lesquoyb/clockinator/docs/design/prototype.html

Clockinator / exploration UX

# Horaires, routines et réveil.

Une interface organisée autour de ce que vous voulez faire : préparer la prochaine nuit, ajuster vos routines et contrôler le réveil.

- Aujourd’hui — la prochaine étape, son contexte et un accès rapide à l’exception.
- Routines — une frise à toucher, des jours à choisir, des détails à ouvrir au besoin.
- Réveil — volume et lumière d’abord ; connexion et diagnostic en détail.

Maquette interactive, données fictives. Essayez la navigation, « Modifier », le saut d’événement, le volume, la lumière et les réglages d’apparence. Rien n’est envoyé à un appareil.

Lire l’audit et les parcours complets

21:14Mode démo

Réglages

Prochain événement

## Aujourd’hui

### Poser le téléphone

Ce soir

22:00

Téléphone + réveil · Semaine

Passer cet événement →

Réveil disponible

État simulé · aucune connexion réelle

Du soir au matin

☾

Se coucher

Ce soir · réveil

23:00

☀

Se réveiller

Demain · téléphone + réveil

07:00

Vos routines

## Routines

### Semaine

Active

Lun – Ven

☾

Poser le téléphone

Téléphone + réveil

22:00

◔

Se coucher

Réveil

23:00

☀

Se réveiller

Téléphone + réveil

07:00

Modifier la routine

Dans cette exploration, une seule routine d’exemple est modifiable. La création et les autres rythmes sont décrits dans l’audit.

Appareil

## Réveil

Clockinator · chambre

Appareil fictif pour la maquette

Le son

### Volume du réveil

3 / 5

12345

Réglage simulé, sans aperçu sonore.

### Lumière

Couleur de la lumière

Éteinte

Ivoire · sélection locale

Connexion, bibliothèque de sons et diagnostic sont détaillés dans la proposition de parcours.

← Retour

## Réglages

### Apparence

Suivre le système ou choisir un thème.

SystèmeClairSombre

Choix conservé dans cette maquette.

À regrouper ici dans l’application

Tags et Focus, permissions Android et synchronisation en arrière-plan. Les commandes du réveil restent dans « Réveil ».

Le thème sombre existe déjà dans Android. Le sélecteur montré ici est une proposition d’évolution.

Routine / étape Réveil

## Heure et jours

Nom de la routineHeure du réveil

Le réveil sonne toujours. Dans l’application, chaque étape dispose de sa feuille de réglage.

Jours actifs

LMMJVSD

Choisissez au moins un jour.

AnnulerEnregistrer
