lesquoyb/clockinator/case-dock/output/dock-L-parts.step

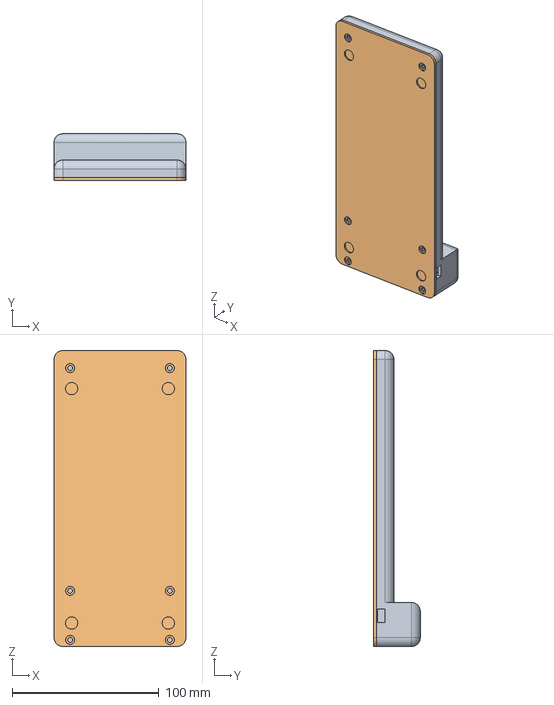
[picture p5: CAD file, 2026-11-05]
case-dock/output/dock-L-parts.step
90.0 x 31.8 x 202.0 mm
