lesquoyb/clockinator/case-v3/output/clockinator-v3-parts.step

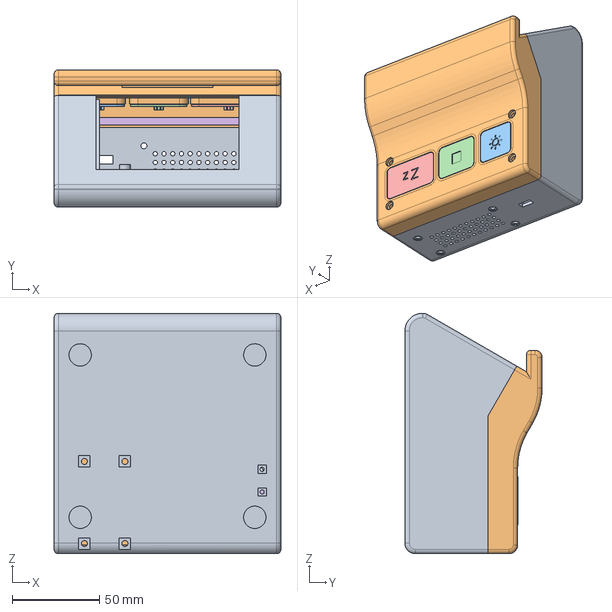
[picture p6: CAD file, 2026-11-12]
case-v3/output/clockinator-v3-parts.step
130.0 x 78.6 x 137.6 mm
