lesquoyb/clockinator/case-dock/output/dock-L-bottom-cover.stl

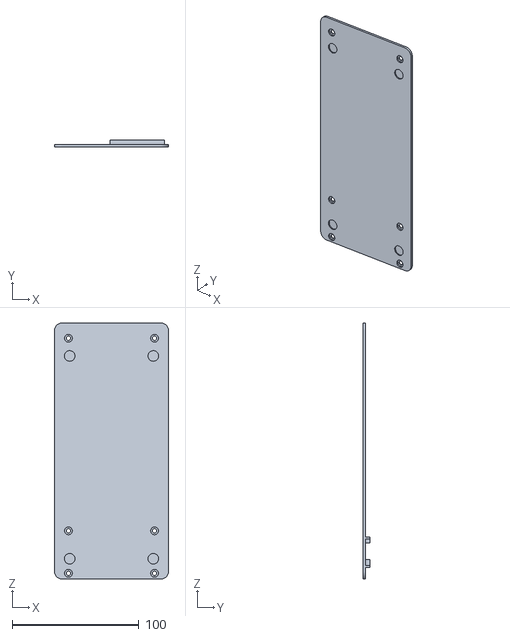
[picture p7: CAD file, 2026-11-05]
case-dock/output/dock-L-bottom-cover.stl
90.0 x 5.30 x 202.0
