lesquoyb/clockinator/case-v3/output/lid.stl

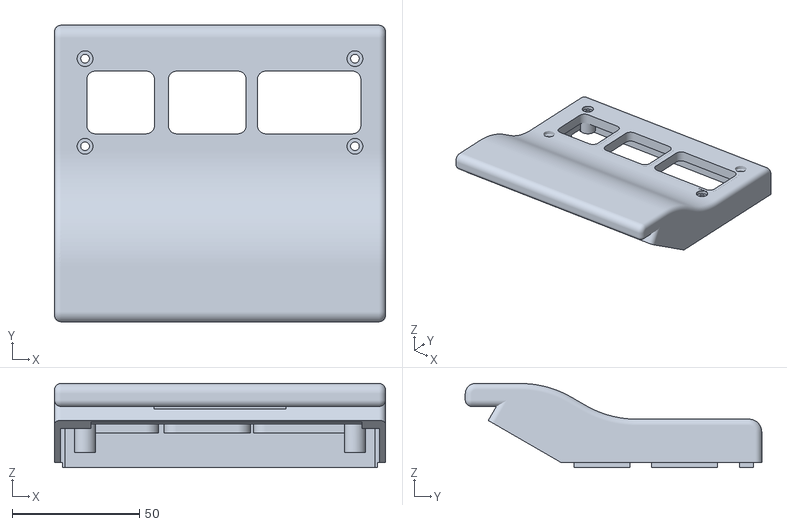
[picture p8: CAD file, 2026-11-12]
case-v3/output/lid.stl
130.0 x 116.5 x 33.0
