lesquoyb/clockinator/case-dock/output/dock-L-body.stl

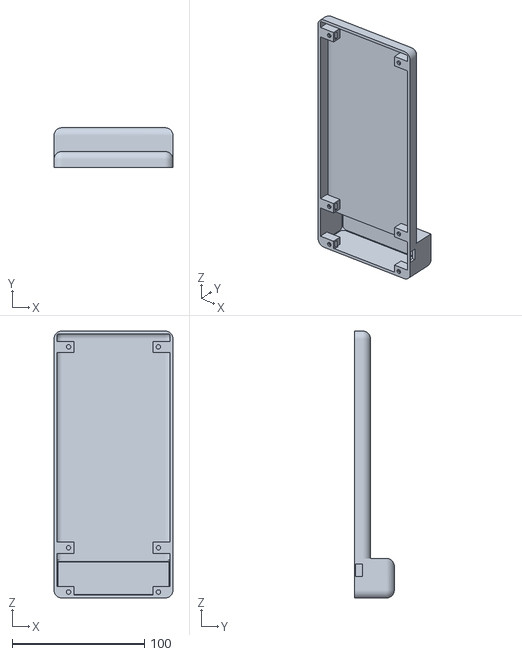
[picture p9: CAD file, 2026-11-05]
case-dock/output/dock-L-body.stl
90.0 x 30.0 x 202.0
