lesquoyb/clockinator/case-v3/output/shell.stl

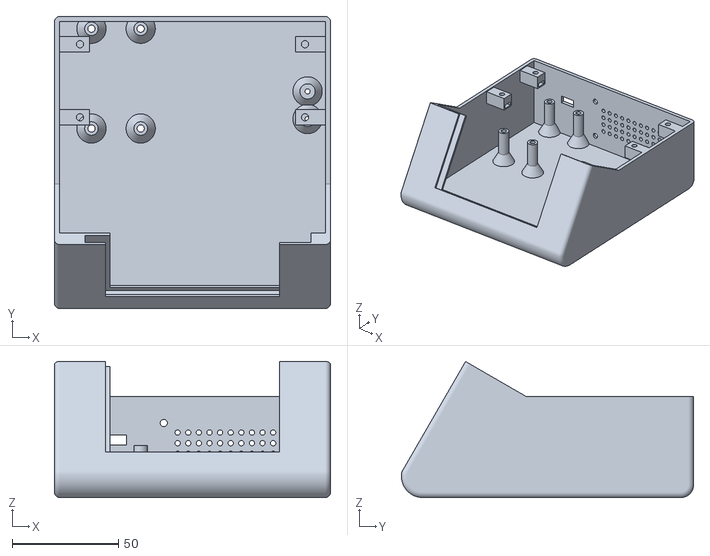
[picture p10: CAD file, 2026-11-10]
case-v3/output/shell.stl
130.0 x 137.6 x 64.1
