lesquoyb/clockinator/case-dock/output/dock-body-smooth.stl

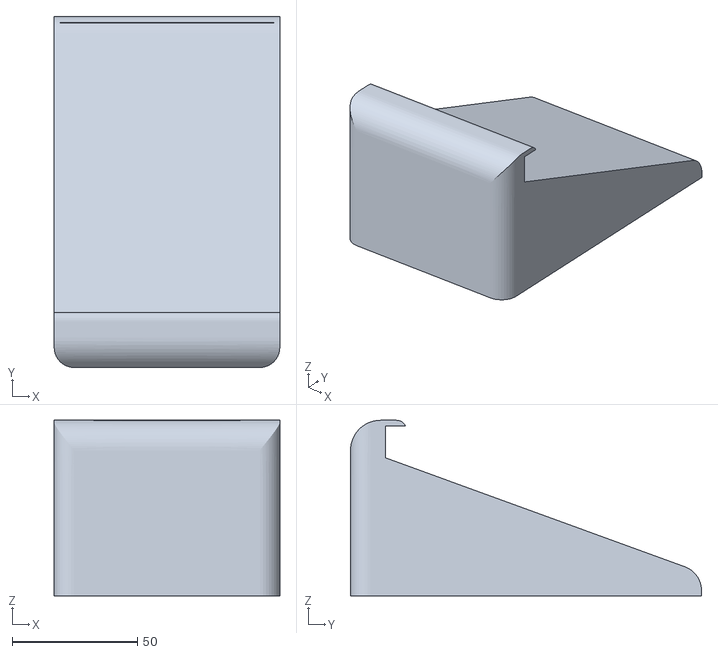
[picture p11: CAD file, 2026-11-01]
case-dock/output/dock-body-smooth.stl
90.0 x 140.0 x 70.0
