lesquoyb/clockinator/case-v3/output/switch-plate.stl

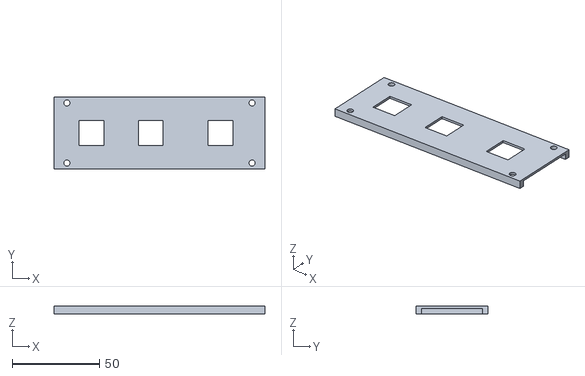
[picture p12: CAD file, 2026-11-06]
case-v3/output/switch-plate.stl
120.8 x 41.0 x 4.40
