lesquoyb/clockinator/case-dock/output/back-cover.stl

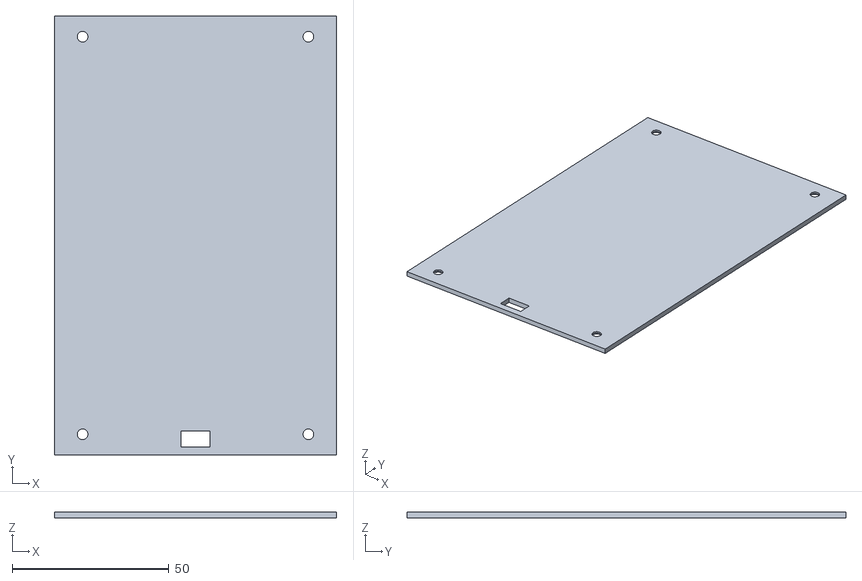
[picture p13: CAD file, 2026-11-01]
case-dock/output/back-cover.stl
90.0 x 140.0 x 1.80
