lesquoyb/clockinator/case-v3/output/key-stop.stl

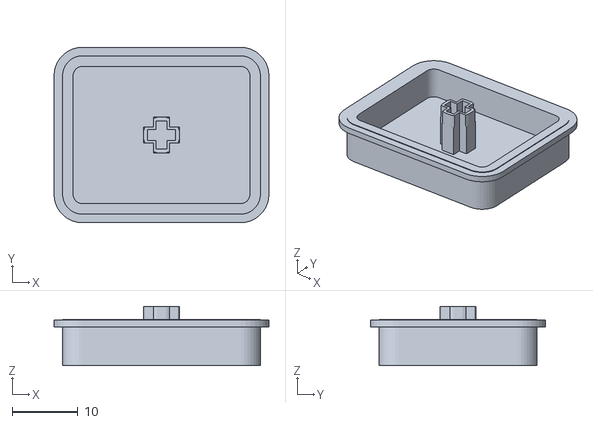
[picture p14: CAD file, 2026-11-01]
case-v3/output/key-stop.stl
32.6 x 26.6 x 9.00
