lesquoyb/clockinator/case-v3/output/key-light.stl

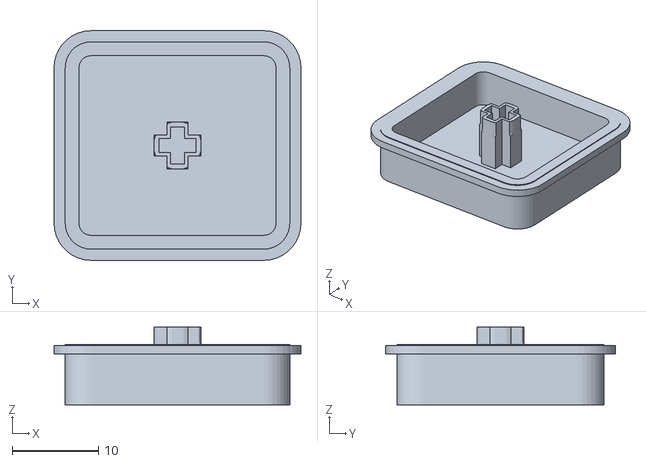
[picture p15: CAD file, 2026-11-01]
case-v3/output/key-light.stl
28.6 x 26.6 x 9.00
