lesquoyb/clockinator/case-v3/output/key-snooze.stl

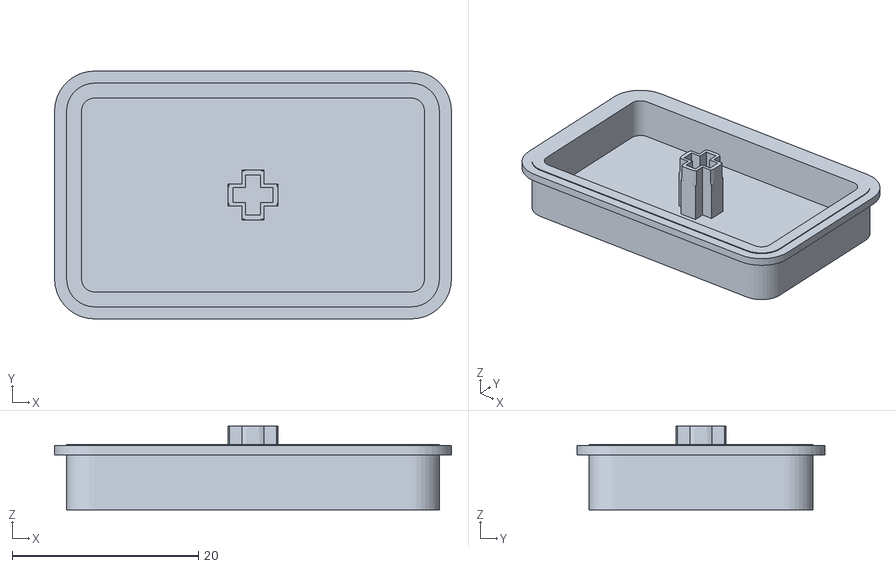
[picture p16: CAD file, 2026-11-01]
case-v3/output/key-snooze.stl
42.6 x 26.6 x 9.00
