lesquoyb/clockinator/case-v3/MAX98357A_3W_I2S_AMP v27.step

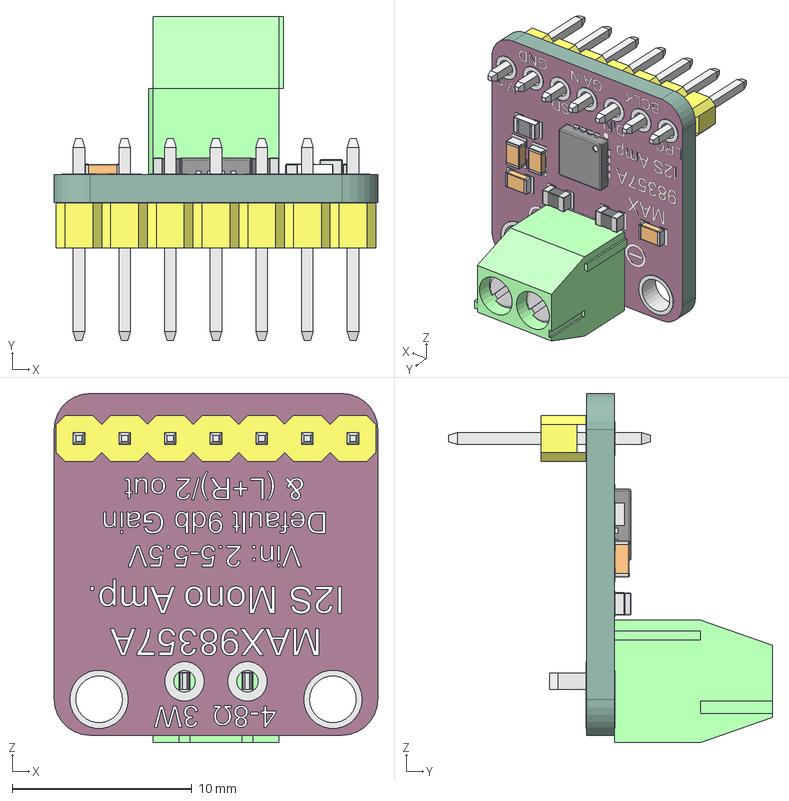
[picture p17: CAD file, 2026-10-31]
case-v3/MAX98357A_3W_I2S_AMP v27.step
18.0 x 18.0 x 19.4 mm
PCB
M1.6x4-Screw030
0805 Ferrite x 2
Header
