lesquoyb/clockinator/(list of files, cad)

Other CAD files:
case-dock/output/back-cover-smooth.stl
case-dock/output/dock-body.stl
case-dock/output/dock-L-assembly.f3d
case-v3/output/clockinator-v3-assembly.f3d
