lesquoyb/clockinator/docs/design/clockinator-wiring.png

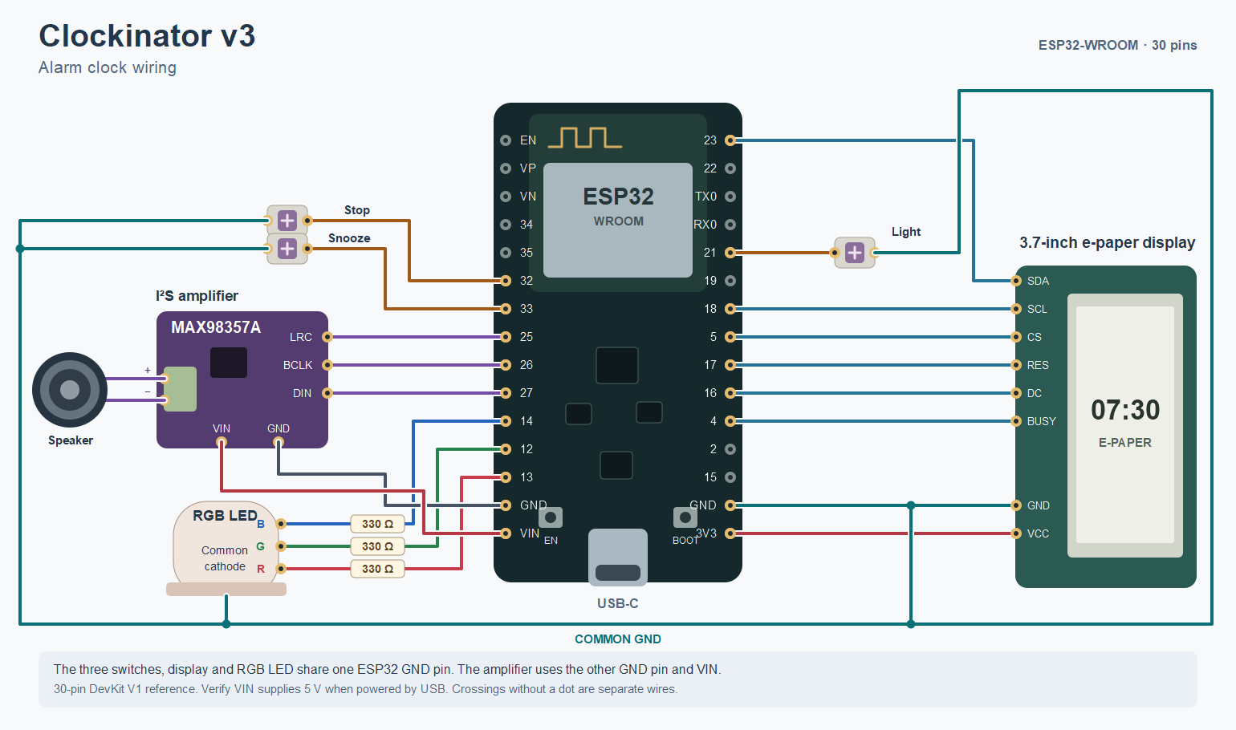
docs/design/clockinator-wiring.png
