lesquoyb/clockinator/esp32/clockinator/clockinator.ino

#include "globals.h"
#include <LittleFS.h>
#include <freertos/FreeRTOS.h>
#include <freertos/queue.h>
#include <freertos/semphr.h>
#include <Preferences.h>
#include <WiFi.h>

/*
 * clockinator.ino
 * Global state definitions, alarm scheduling, and main loop.
 *
 * Thread-safety model
 * -------------------
 * Core 0: BLE callbacks queue incoming payloads and connection events.
 *         They do not mutate the clock, alarm map, SPI or I2S state.
 * Core 1: Arduino loop(). Owns the display and the I2S driver. Drains
 *         incoming payloads and cmdQueue, including payloads during audio.
 *
 * Shared state accessed from both cores uses 'volatile' where a single
 * word-sized read/write is sufficient. Multi-field updates are protected
 * by only writing from the loop core (commands are queued, not applied
 * directly by the BLE task).
 */

/* -------------------------------------------------------------------------
 * Cross-core command queue (depth = 8, each item is a PendingCommand)
 * -------------------------------------------------------------------------*/
QueueHandle_t cmdQueue;
static QueueHandle_t wifiConfigQueue;

struct WifiCredentials {
    char ssid[33];
    char password[65];
};
static WifiCredentials pendingWifiCredentials{};
static bool pendingWifiCredentialsValid = false;

static WiFiServer wifiServer(4210);
static WiFiClient wifiClient;
static SemaphoreHandle_t wifiClientMutex;
static String wifiInput;
static bool wifiServerStarted = false;
static bool wasWifiConnected = false;
static bool wifiProvisioningAttemptActive = false;
static uint32_t wifiProvisioningStartedAt = 0;
static const uint32_t WIFI_CONNECT_TIMEOUT_MS = 20000;
static bool wifiInitialConnectionExpected = false;
static uint32_t wifiInitializationStartedAt = 0;

bool clockConnectionsReadyForRefresh() {
    if ((WiFi.status() == WL_CONNECTED) != is_wifi_connected) return false;
    return !wifiProvisioningAttemptActive && (!wifiInitialConnectionExpected ||
        WiFi.status() == WL_CONNECTED ||
        millis() - wifiInitializationStartedAt >= WIFI_CONNECT_TIMEOUT_MS);
}

/* Post a command from any task/core without blocking. */
void postCommand(PendingCommandType type, int minutes) {
    PendingCommand cmd;
    cmd.type    = type;
    cmd.minutes = minutes;
    /* xQueueSendFromISR would be needed inside an ISR; xQueueSend is fine
       from a regular FreeRTOS task (BLE callback). */
    xQueueSend(cmdQueue, &cmd, 0);
}

/* -------------------------------------------------------------------------
 * Global state definitions  (extern declarations live in globals.h)
 * -------------------------------------------------------------------------*/
time_t          start_time              = 0;
time_t          next_alarm              = 0;
RingtoneType    next_alarm_type         = RT_UNKNOWN;
std::string     next_alarm_id;
bool            is_bluetooth_connected  = false;
bool            is_wifi_connected       = false;

std::map<std::string, Alarm> alarms;

volatile bool         isRinging      = false;
volatile RingtoneType firingRingtone = RT_UNKNOWN;
std::string           firingAlarmId;
const char*           activeRingtoneFile = "";
static std::string    activeRingtoneStorage;
static std::string snoozedAlarmId;
static RingtoneType snoozedRingtone = RT_UNKNOWN;
static time_t snoozedUntil = 0;
static std::string snoozeCycleAlarmId;
static RingtoneType snoozeCycleRingtone = RT_UNKNOWN;
static size_t snoozeCycleIndex = 0;

static constexpr int DEFAULT_RING_TIMEOUT_MINUTES = 20;
static int ringTimeoutMinutes = DEFAULT_RING_TIMEOUT_MINUTES;
static int savedRingTimeoutMinutes = DEFAULT_RING_TIMEOUT_MINUTES;
static uint32_t ringStartedAt = 0;

void setRingTimeoutMinutes(int minutes) {
    if (minutes < 1 || minutes > 120) return;
    ringTimeoutMinutes = minutes;
    if (minutes == savedRingTimeoutMinutes) return;
    Preferences prefs;
    if (prefs.begin("clock-alarm", false)) {
        if (prefs.putInt("timeout-min", minutes) == sizeof(int32_t))
            savedRingTimeoutMinutes = minutes;
        prefs.end();
    }
    if (minutes != savedRingTimeoutMinutes) Serial.println("Could not persist alarm ring timeout");
}

void serviceRingTimeout() {
    // The audio preview has its own five-second timeout and uses RT_UNKNOWN.
    if (isRinging && firingRingtone != RT_UNKNOWN &&
        uint32_t(millis() - ringStartedAt) >= uint32_t(ringTimeoutMinutes) * 60000U) {
        stopAlarm();
    }
}

bool hasPendingSnooze() { return snoozedUntil > 0 && !snoozedAlarmId.empty(); }

bool selectAlarmControlTarget(const char* id, RingtoneType type) {
    const bool any = !id || !*id;
    if (!firingAlarmId.empty() && (any || firingAlarmId == id) &&
        (type == RT_UNKNOWN || type == firingRingtone)) return true;
    if (hasPendingSnooze() && (any || snoozedAlarmId == id) &&
        (type == RT_UNKNOWN || type == snoozedRingtone)) {
        firingAlarmId = snoozedAlarmId;
        firingRingtone = snoozedRingtone;
        return true;
    }
    return any && isRinging;
}

void stopFromPhysicalButton() {
    selectAlarmControlTarget("", RT_UNKNOWN);
    cancelAudioTest();
    stopAlarm();
    snoozeCycleAlarmId.clear();
    snoozeCycleIndex = 0;
}

void cyclePhysicalSnooze() {
    if (!selectAlarmControlTarget("", RT_UNKNOWN) || firingAlarmId.empty()) return;
    if (snoozeCycleAlarmId != firingAlarmId || snoozeCycleRingtone != firingRingtone) {
        snoozeCycleAlarmId = firingAlarmId;
        snoozeCycleRingtone = firingRingtone;
        snoozeCycleIndex = 0;
    }
    const auto it = alarms.find(firingAlarmId);
    if (it == alarms.end() || it->second.snoozeDurations.empty()) return;
    const auto& durations = it->second.snoozeDurations;
    const int minutes = durations[snoozeCycleIndex % durations.size()];
    snoozeCycleIndex = (snoozeCycleIndex + 1) % durations.size();
    snoozeAlarm(minutes);
}

/* -------------------------------------------------------------------------
 * setNextAlarm
 * Recalculates next_alarm / next_alarm_type / next_alarm_id.
 * Must only be called from core 1 (main loop).
 * Does NOT call drawClock(): the caller is responsible for refreshing the
 * display at the right time to avoid cross-core SPI access.
 * -------------------------------------------------------------------------*/
void setNextAlarm() {
    time_t now      = start_time + (time_t)(millis() / 1000);
    time_t earliest = 0;
    next_alarm_type = RT_UNKNOWN;
    next_alarm_id.clear();

    for (auto& kv : alarms) {
        Alarm& a = kv.second;
        if (!a.isEnabled) continue;
        for (int slot = 0; slot < 3; slot++) {
            RingtoneType type = (RingtoneType)slot;
            if (a.isDismissed(type) && now >= a.dismissedUntil[slot])
                a.setDismissed(type, false);
        }

        RingtoneType t;
        time_t ts = a.nextAnyTrigger(now, t);
        if (ts > 0 && (earliest == 0 || ts < earliest)) {
            earliest        = ts;
            next_alarm_type = t;
            next_alarm_id   = a.id;
        }
    }

    if (hasPendingSnooze()) {
        const auto it = alarms.find(snoozedAlarmId);
        if (it == alarms.end() || !it->second.isEnabled ||
            !it->second.slot(snoozedRingtone).enabled || !it->second.slot(snoozedRingtone).ringOnDevice) {
            snoozedUntil = 0;
            snoozedAlarmId.clear();
        } else if (earliest == 0 || snoozedUntil < earliest) {
            earliest = snoozedUntil;
            next_alarm_id = snoozedAlarmId;
            next_alarm_type = snoozedRingtone;
        }
    }
    next_alarm = earliest;
}

/* -------------------------------------------------------------------------
 * startRinging
 * Must only be called from core 1.
 * -------------------------------------------------------------------------*/
void startRinging() {
    if (snoozedAlarmId == firingAlarmId && snoozedRingtone == firingRingtone) {
        snoozedUntil = 0;
        snoozedAlarmId.clear();
    }
    auto it = alarms.find(firingAlarmId);
    if (it != alarms.end() && !it->second.ringtoneFile.empty()) {
        // Keep playback's path valid when a subsequent SYNC replaces the alarm map.
        activeRingtoneStorage = it->second.ringtoneFile;
        activeRingtoneFile = activeRingtoneStorage.c_str();
    } else {
        activeRingtoneFile = "";
    }
    ringStartedAt = millis();
    isRinging = true;
}

/* -------------------------------------------------------------------------
 * stopAlarm
 * Must only be called from core 1.
 * Silences the current alarm, notifies the phone, then reschedules.
 * -------------------------------------------------------------------------*/
void stopAlarm() {
    if (snoozedAlarmId == firingAlarmId && snoozedRingtone == firingRingtone) {
        snoozedUntil = 0;
        snoozedAlarmId.clear();
    }
    isRinging          = false;
    activeRingtoneFile = "";
    i2s_zero_dma_buffer(I2S_PORT);

    /* Notify the phone so it mirrors the stop. */
    if (!firingAlarmId.empty() && firingRingtone != RT_UNKNOWN) {
        char buf[256];
        snprintf(buf, sizeof(buf),
            "{\"action\":\"STOP_ALARM\",\"alarmId\":\"%s\",\"ringtone\":\"%s\"}",
            firingAlarmId.c_str(), ringtoneToWire(firingRingtone));
        notifyPhone(buf);
    }

    /* Clear the dismiss flag so the alarm fires again next cycle. */
    auto it = alarms.find(firingAlarmId);
    if (it != alarms.end())
        it->second.setDismissed(firingRingtone, false);

    next_alarm = 0;
    setNextAlarm();
    firingAlarmId.clear();
    firingRingtone = RT_UNKNOWN;
    drawClock();   /* safe: we are on core 1 */
}

/* -------------------------------------------------------------------------
 * snoozeAlarm
 * Must only be called from core 1.
 * -------------------------------------------------------------------------*/
void snoozeAlarm(int minutes) {
    if (minutes < 1 || minutes > 1440 || firingAlarmId.empty() || firingRingtone == RT_UNKNOWN) return;
    isRinging          = false;
    activeRingtoneFile = "";
    i2s_zero_dma_buffer(I2S_PORT);

    /* Notify the phone. */
    if (!firingAlarmId.empty() && firingRingtone != RT_UNKNOWN) {
        char buf[256];
        snprintf(buf, sizeof(buf),
            "{\"action\":\"SNOOZE_ALARM\",\"alarmId\":\"%s\",\"ringtone\":\"%s\",\"minutes\":%d}",
            firingAlarmId.c_str(), ringtoneToWire(firingRingtone), minutes);
        notifyPhone(buf);
    }

    time_t now      = start_time + (time_t)(millis() / 1000);
    snoozedUntil    = now + (time_t)(minutes * 60);
    snoozedRingtone = firingRingtone;
    snoozedAlarmId  = firingAlarmId;
    setNextAlarm();
    firingAlarmId.clear();
    firingRingtone = RT_UNKNOWN;
    drawClock(); // Android and physical snooze commands immediately update the time shown.
}

/* -------------------------------------------------------------------------
 * drainCommandQueue
 * Called at the top of loop(): applies all pending commands posted by the
 * BLE task. Everything here runs on core 1, so SPI/I2S accesses are safe.
 * Returns true if any command was processed (caller may want to redraw).
 * -------------------------------------------------------------------------*/
static bool drainCommandQueue() {
    PendingCommand cmd;
    bool anyProcessed = false;
    bool redraw = false;

    while (xQueueReceive(cmdQueue, &cmd, 0) == pdTRUE) {
        anyProcessed = true;
        switch (cmd.type) {
            case CMD_STOP:
                stopAlarm();
                break;
            case CMD_SNOOZE:
                snoozeAlarm(cmd.minutes);
                break;
            case CMD_SYNC_PUSH:
                /* Incoming messages were applied on this core; recalculate. */
                setNextAlarm();
                redraw = true;
                break;
            case CMD_BLE_CONNECTED:
                is_bluetooth_connected = true;
                noteClockLinkChange();
                redraw = true;
                break;
            case CMD_BLE_DISCONNECTED:
                is_bluetooth_connected = false;
                noteClockLinkChange();
                redraw = true;
                break;
            default:
                if (cmd.type == CMD_DISPLAY_REFRESH) { requestFullClockRefresh(); redraw = true; }
                break;
        }
    }
    if (redraw) drawClock();
    return anyProcessed;
}

void queueWifiCredentials(const char* ssid, const char* password) {
    if (!wifiConfigQueue || !ssid || strlen(ssid) == 0) return;
    WifiCredentials credentials{};
    strncpy(credentials.ssid, ssid, sizeof(credentials.ssid) - 1);
    strncpy(credentials.password, password ? password : "", sizeof(credentials.password) - 1);
    xQueueOverwrite(wifiConfigQueue, &credentials);
}

void initWifi() {
    wifiClientMutex = xSemaphoreCreateMutex();
    WiFi.mode(WIFI_STA);

    Preferences preferences;
    preferences.begin("clockinator", true);
    String ssid = preferences.getString("ssid", "");
    String password = preferences.getString("password", "");
    preferences.end();

    wifiInitialConnectionExpected = ssid.length() > 0;
    wifiInitializationStartedAt = millis();
    if (wifiInitialConnectionExpected) WiFi.begin(ssid.c_str(), password.c_str());
}

void notifyWifiClient(const char* message) {
    if (!wifiClientMutex) return;
    if (xSemaphoreTake(wifiClientMutex, pdMS_TO_TICKS(100)) != pdTRUE) return;
    if (wifiClient && wifiClient.connected()) {
        wifiClient.print(message);
        wifiClient.write('\n');
    }
    xSemaphoreGive(wifiClientMutex);
}

void notifyWifiStatus() {
    bool connected = WiFi.status() == WL_CONNECTED;
    JsonDocument document;
    document["action"] = "WIFI_STATUS";
    document["firmwareVersion"] = CLOCKINATOR_VERSION;
    document["status"] = connected ? "connected" : "disconnected";
    document["connected"] = connected;
    if (connected) document["ip"] = WiFi.localIP().toString();

    char message[192];
    serializeJson(document, message, sizeof(message));
    notifyPhone(message);
}

static const char* wifiConnectionError(wl_status_t status) {
    switch (status) {
        case WL_NO_SSID_AVAIL:
            return "Network not found; verify the SSID and supported Wi-Fi band.";
        case WL_CONNECT_FAILED:
            return "Authentication failed; verify the Wi-Fi password.";
        case WL_CONNECTION_LOST:
            return "Wi-Fi connection lost before setup completed.";
        default:
            return "Connection timed out; verify SSID, password, signal, and ESP32 band support.";
    }
}

static void notifyWifiError(wl_status_t status) {
    JsonDocument document;
    document["action"] = "WIFI_STATUS";
    document["status"] = "error";
    document["connected"] = false;
    document["error"] = wifiConnectionError(status);
    document["reasonCode"] = static_cast<int>(status);

    char message[256];
    serializeJson(document, message, sizeof(message));
    notifyPhone(message);
}

void serviceWifi() {
    WifiCredentials credentials{};
    if (wifiConfigQueue && xQueueReceive(wifiConfigQueue, &credentials, 0) == pdTRUE) {
        pendingWifiCredentials = credentials;
        pendingWifiCredentialsValid = true;

        WiFi.disconnect(false, false);
        wifiServerStarted = false;
        wasWifiConnected = false;
        is_wifi_connected = false;
        wifiProvisioningAttemptActive = true;
        wifiProvisioningStartedAt = millis();
        drawClock();
        JsonDocument status;
        status["action"] = "WIFI_STATUS";
        status["status"] = "connecting";
        status["connected"] = false;
        status["ssid"] = credentials.ssid;
        char message[128];
        serializeJson(status, message, sizeof(message));
        notifyPhone(message);
        WiFi.begin(credentials.ssid, credentials.password);
    }

    bool connected = WiFi.status() == WL_CONNECTED;
    if (connected && !wifiServerStarted) {
        wifiServer.begin();
        wifiServer.setNoDelay(true);
        wifiServerStarted = true;
        
    }
    if (connected != wasWifiConnected) {
        wasWifiConnected = connected;
        is_wifi_connected = connected;
        noteClockLinkChange();
        if (connected) {
            wifiProvisioningAttemptActive = false;
            if (pendingWifiCredentialsValid) {
                Preferences preferences;
                preferences.begin("clockinator", false);
                preferences.putString("ssid", pendingWifiCredentials.ssid);
                preferences.putString("password", pendingWifiCredentials.password);
                preferences.end();
                pendingWifiCredentialsValid = false;
            }
        }
        if (!connected) {
            wifiServerStarted = false;
            if (wifiClientMutex &&
                xSemaphoreTake(wifiClientMutex, pdMS_TO_TICKS(100)) == pdTRUE) {
                wifiClient.stop();
                wifiInput = "";
                xSemaphoreGive(wifiClientMutex);
            }
        }
        drawClock();
        notifyWifiStatus();
    }

    if (!connected && wifiProvisioningAttemptActive &&
        millis() - wifiProvisioningStartedAt >= WIFI_CONNECT_TIMEOUT_MS) {
        wifiProvisioningAttemptActive = false;
        notifyWifiError(WiFi.status());
    }

    if (!connected || !wifiServerStarted) return;

    if (wifiServer.hasClient()) {
        WiFiClient incoming = wifiServer.available();
        if (incoming && wifiClientMutex &&
            xSemaphoreTake(wifiClientMutex, pdMS_TO_TICKS(100)) == pdTRUE) {
            if (wifiClient) wifiClient.stop();
            wifiClient = incoming;
            wifiClient.setNoDelay(true);
            wifiInput = "";
            xSemaphoreGive(wifiClientMutex);
        }
    }

    while (true) {
        String line;
        bool completeLine = false;
        if (wifiClientMutex &&
            xSemaphoreTake(wifiClientMutex, pdMS_TO_TICKS(100)) == pdTRUE) {
            if (wifiClient && !wifiClient.connected()) {
                wifiClient.stop();
                wifiInput = "";
            }
            while (wifiClient && wifiClient.connected() && wifiClient.available()) {
                char character = (char)wifiClient.read();
                if (character == '\n') {
                    line = wifiInput;
                    wifiInput = "";
                    completeLine = true;
                    break;
                }
                if (character != '\r' && wifiInput.length() < 4096) wifiInput += character;
                else if (wifiInput.length() >= 4096) wifiInput = "";
            }
            xSemaphoreGive(wifiClientMutex);
        }
        if (!completeLine) break;
        processIncomingCommand(line);
    }
}

/* -------------------------------------------------------------------------
 * setup / loop
 * -------------------------------------------------------------------------*/
void setup() {
    Serial.begin(115200);
    /* Create the command queue before starting anything that might use it. */
    cmdQueue = xQueueCreate(8, sizeof(PendingCommand));
    wifiConfigQueue = xQueueCreate(1, sizeof(WifiCredentials));

    Preferences alarmPrefs;
    if (alarmPrefs.begin("clock-alarm", true)) {
        const int savedMinutes = alarmPrefs.getInt("timeout-min", DEFAULT_RING_TIMEOUT_MINUTES);
        if (savedMinutes >= 1 && savedMinutes <= 120) {
            ringTimeoutMinutes = savedMinutes;
            savedRingTimeoutMinutes = savedMinutes;
        }
        alarmPrefs.end();
    }
    initAlarmVolume();
    initAudioTest();
    setupI2S();

    if (!LittleFS.begin(true))
        show("FS Error", "LittleFS failed");

    initDisplay();
    initWifi();
    initBluetoothServer();
    initPhysicalControls();
}

void loop() {
    servicePhysicalControls();
    applyPhysicalControls();
    serviceIncomingBluetooth();
    serviceAlarmVolume();
    /* Drain any commands posted by the BLE task first. */
    drainCommandQueue();
    serviceWifi();
    serviceAlarmVolume();
    serviceAudioTest();
    serviceRingTimeout();
    refreshVolumeDisplay();
    serviceClockRefresh();

    time_t now = start_time + (time_t)(millis() / 1000);

    /* Refresh the clock independently of alarm playback. */
    if (now / 60 != lastClockMinute) {
        drawClock();
    }

    // A scheduled alarm takes priority over a volume preview.
    if (next_alarm > 0 && now >= next_alarm) cancelAudioTest();
    if (!isRinging && next_alarm > 0 && now >= next_alarm) {
        firingRingtone = next_alarm_type;
        firingAlarmId  = next_alarm_id;
        next_alarm     = 0;
        startRinging();
    }

    if (isRinging) playAlarm();
    applyPhysicalControls();
    refreshVolumeDisplay();

    // Keep the background loop cadence while sampling buttons during its idle wait.
    for (int elapsedMs = 0; elapsedMs < 100; elapsedMs += 10) {
        delay(10);
        servicePhysicalControls();
    }
}
