lesquoyb/clockinator/(commit log)

2026-09-24 refactor esp32 code
2026-10-01 rework the whole app and esp architecture
    - makes the alarm loop until stop explicitly sent
    - adds configurable snooze options
    - cleanup code and refactor
    - remember paired devices and automatically reconnect
    - finished the complete interaction loop
    - handling of named tags for stopping alarms
    - adding an optional third slot for an alarm
    [AlarmDialog.kt, BleManager.kt]
2026-10-01 Fixes esp32 freezing while playing the ringtone and actually sending snooze and stop from the phone
    [bluetooth.ino, clockinator.ino, sound.ino]
2026-10-01 [android] rework UI to simplify and add a coherent theme
    [AlarmDialog.kt]
2026-10-01 [android] continue with UX rework, navigation simplification and onboarding
    [AlarmDialog.kt]
2026-10-01 [android] set mandatory alarms + renaming + fixes bugged bedtime alarm sound setting + hardly visible save button
    [AlarmDialog.kt]
2026-10-07 Fixes numerous bugs related to dismissing/snoozing alarms in both the app and the clock
    [BleManager.kt]
2026-10-08 [esp32] adding physical buttons for stop,snooze and light + the led control
2026-10-31 [case] first attempt at a case
    [KS-33 Low Profile 2.0 KS33-20230109（KS-33-Y31 3D图）.stp, WeAct-EpaperModule-3 - clean.f3d, WeAct-EpaperModule-3.7 Board 3D.step, boitier.stl, bouchon-diffuseur.stl, cache-fils-led.stl, capot-esp32.stl, casquette-lumineuse.stl]
2026-10-31 [case] rounded version + simplify the switch supports and screws + proper support for max98357A
    [MAX98357A_3W_I2S_AMP v27.step]
2026-10-31 [case] english translation + stl exports
    [clockinator-v3-assembly.f3d, clockinator-v3-parts.step, diffuser-0.6mm.stl, diffuser-0.8mm.stl, diffuser-1.2mm.stl, diffuser-plug.stl, key-light.stl, key-snooze.stl]
2026-11-01 [case] update the exported stl and add rendered visuals
    [clockinator-v3-assembly.f3d, clockinator-v3-parts.step, key-light.stl, key-snooze.stl, key-stop.stl, lid.stl, shell.stl, switch-plate.stl]
2026-11-01 {case] adding some phone dock prototypes
    [back-cover-smooth.stl, back-cover.stl, dock-L-body.stl, dock-L-bottom-cover.stl, dock-body-smooth.stl, dock-body.stl]
2026-11-04 [case] adds rubber feet spots in phone dock + improves documentation
    [dock-L-assembly.f3d, dock-L-body.stl, dock-L-bottom-cover.stl, dock-L-parts.step]
2026-11-05 [case] fixes holes in dock model and updates pcb support + documentation
    [dock-L-assembly.f3d, dock-L-body.stl, dock-L-bottom-cover.stl, dock-L-parts.step]
2026-11-06 fix(case): build switch plate without obsolete cable notches
    [clockinator-v3-parts.step, switch-plate.stl]
2026-11-06 fix(case): build ESP32 supports without compensating rear-wall cutouts
    [clockinator-v3-parts.step, shell.stl]
2026-11-07 [case] update rendering, build and fusion files
    [clockinator-v3-assembly.f3d, dock-L-assembly.f3d]
2026-11-10 [case] fixes nut spots and screen covering
    [clockinator-v3-assembly.f3d, clockinator-v3-parts.step, shell.stl]
2026-11-10 [case] centers screen
    [clockinator-v3-assembly.f3d, clockinator-v3-parts.step, shell.stl]
2026-11-12 [clock] Removes the guard on the light button so it acts like the others
2026-11-12 [case] updates BOM
2026-11-12 [case] improves inner guide and fixes screen space + removes v2
    [KS-33 Low Profile 2.0 KS33-20230109（KS-33-Y31 3D图）.stp, WeAct-EpaperModule-3 - clean.f3d, WeAct-EpaperModule-3.7 Board 3D.step, boitier.stl, bouchon-diffuseur.stl, cache-fils-led.stl, capot-esp32.stl, casquette-lumineuse.stl]
2026-11-12 wider opening for the LED + removal of diffuser and diffuser stop
    [clockinator-v3-assembly.f3d, clockinator-v3-parts.step, diffuser-0.6mm.stl, diffuser-0.8mm.stl, diffuser-1.2mm.stl, diffuser-plug.stl, lid.stl]
2026-11-12 [case] stronger inner guide
    [clockinator-v3-assembly.f3d, clockinator-v3-parts.step, lid.stl]
2026-11-12 [clock] move the light button on gpio 21
2026-11-12 [clock] adding wiring schema + polling light press more often
2026-11-13 Add Clockinator assembly manual and app tutorials
2026-11-13 Add alarm auto-stop and illustrate the assembly manual
